GBert/EasyCAN/hardware/BOM.md

BOM
===

```
R1			4k7
R2,R7		330  (20mA LED)
R3			1k
R4			120
R5,R6		33
R8			1k	optional (MCP2551 bzw. 2561)

C1			100nF
C2,C3		22pF
C4-C7		100nF
C8,C9		100pF
C10			100nF	optional 

IC1			PIC18F25K80 or PIC18F26K80
Q1			16MHz

DC1			5V DCDC SIL4	optional
			NUP2105L        CAN protection optional 
```
