GBert/EasyCAN/(threads)

Thread 1 (2025-07-08):

Comparison operator wrong

WebDust21, 2025-07-08:
https://github.com/GBert/EasyCAN/blob/0a382b3a9a484f9f415d9f06ae92aa9af49ba99f/software/old/xc8_test/can/ecan.c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

This needs to be:

```
while (CANSTATbits.OPMODE != 0x00);
```

The only reason it doesn't lock up the processor indefinitely as written, is because the mode switch doesn't happen instantly.
