GBert/EasyCAN/hardware/GBox2-can_diy.pdf

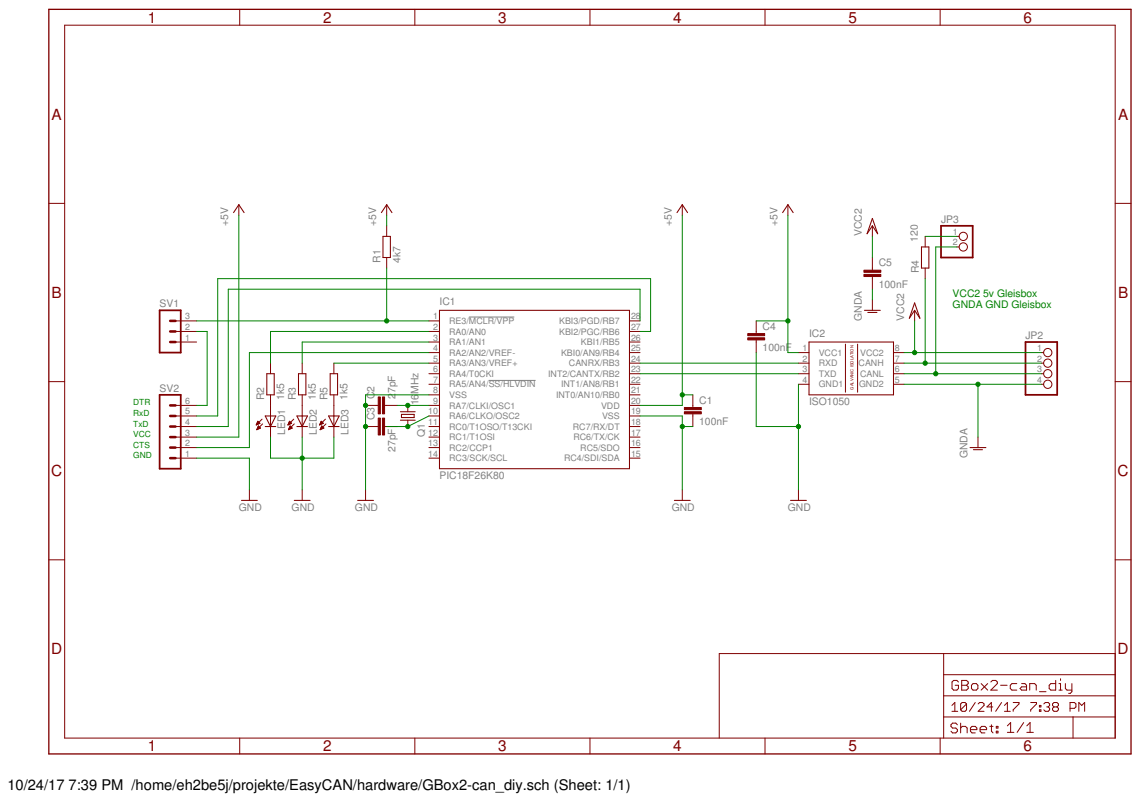
[picture p5: page 1]

VCC2 5v Gleisbox GNDA GND Gleisbox

10/24/17 7:39 PM /home/eh2be5j/projekte/EasyCAN/hardware/GBox2-can_diy.sch (Sheet: 1/1)
