GBert/EasyCAN/hardware/EasyCAN.pdf

# GND⁺⁵V

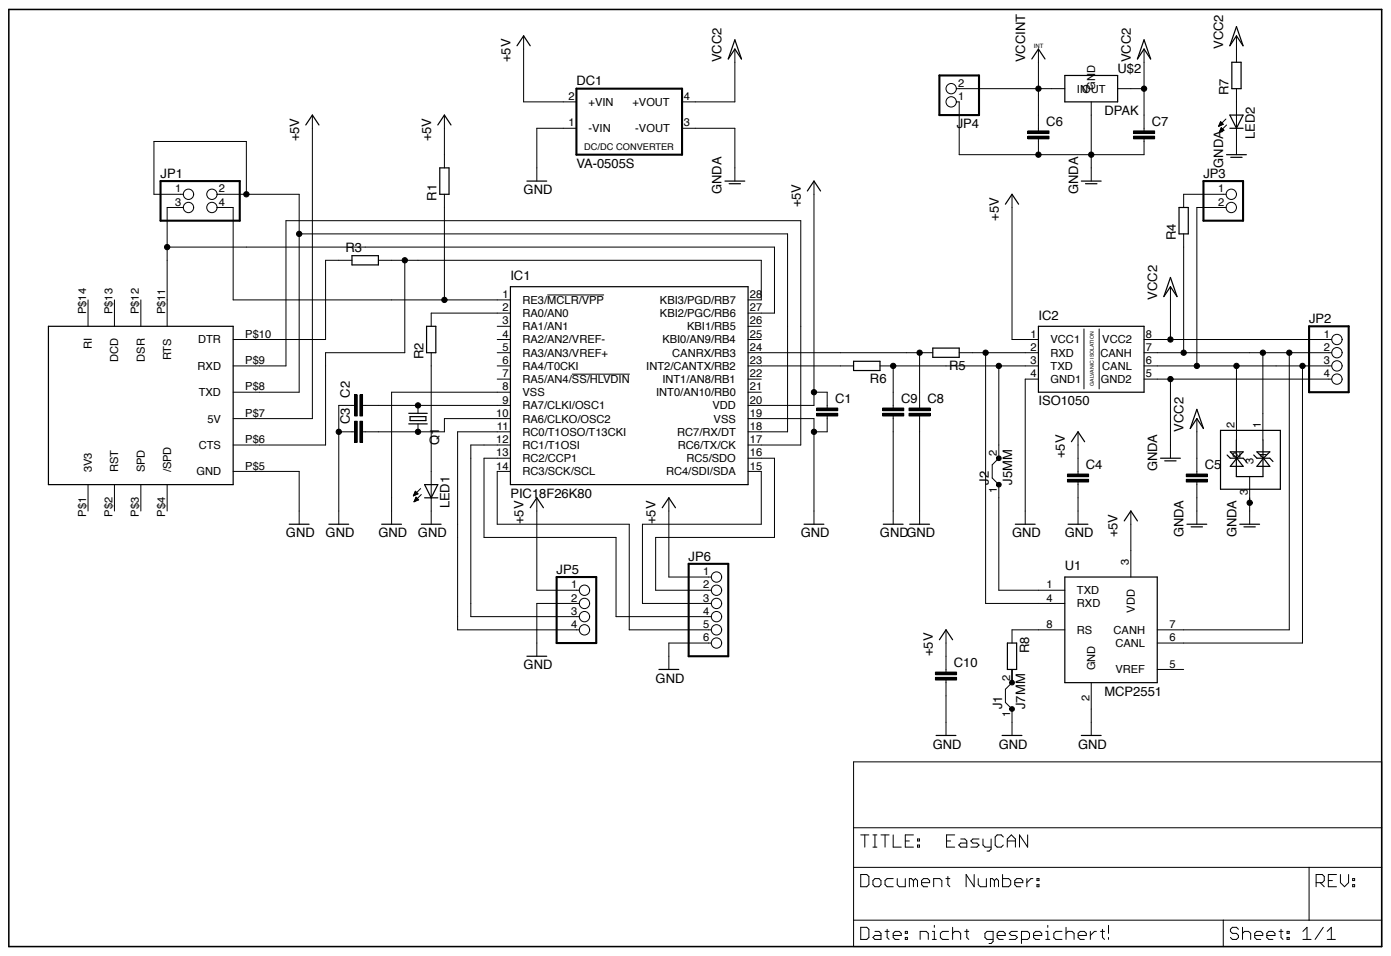
[picture p6: page 1]
