GBert/EasyCAN/hardware/EasyCAN_diy.pdf

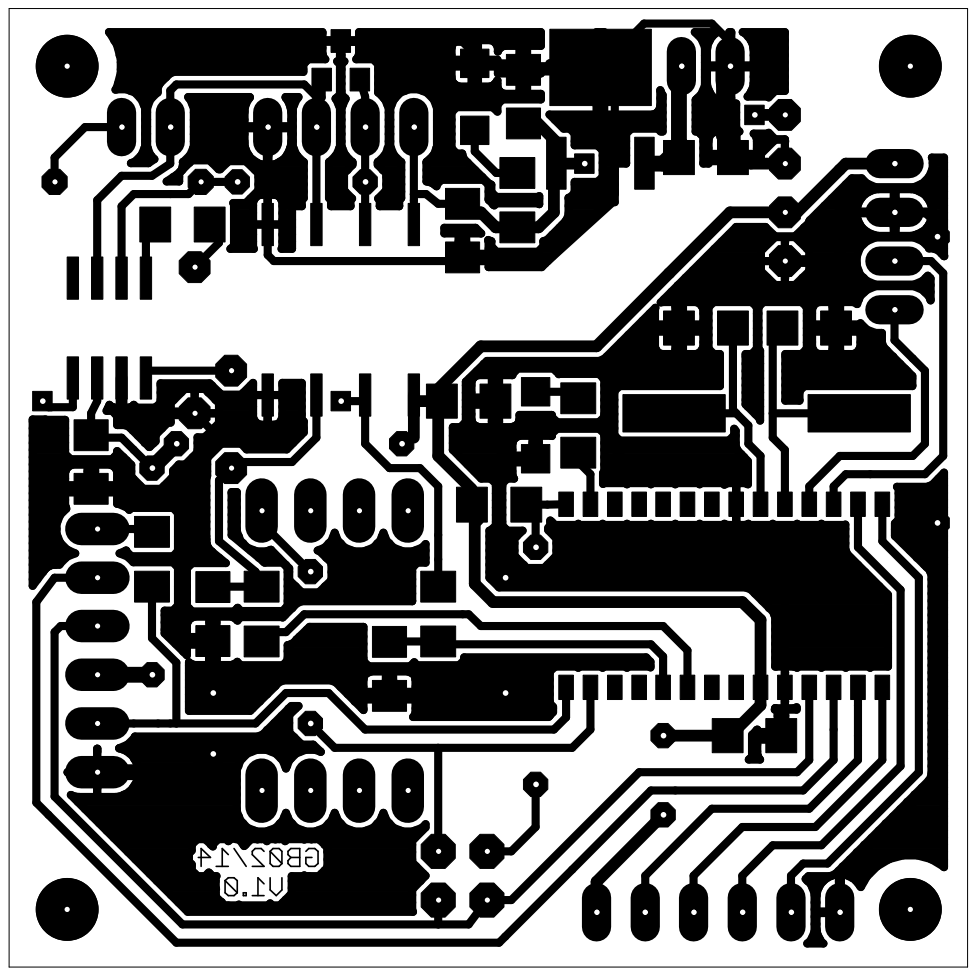
[picture p7: page 1]
