GBert/EasyCAN/hardware/EasyCAN_diy_multi.pdf

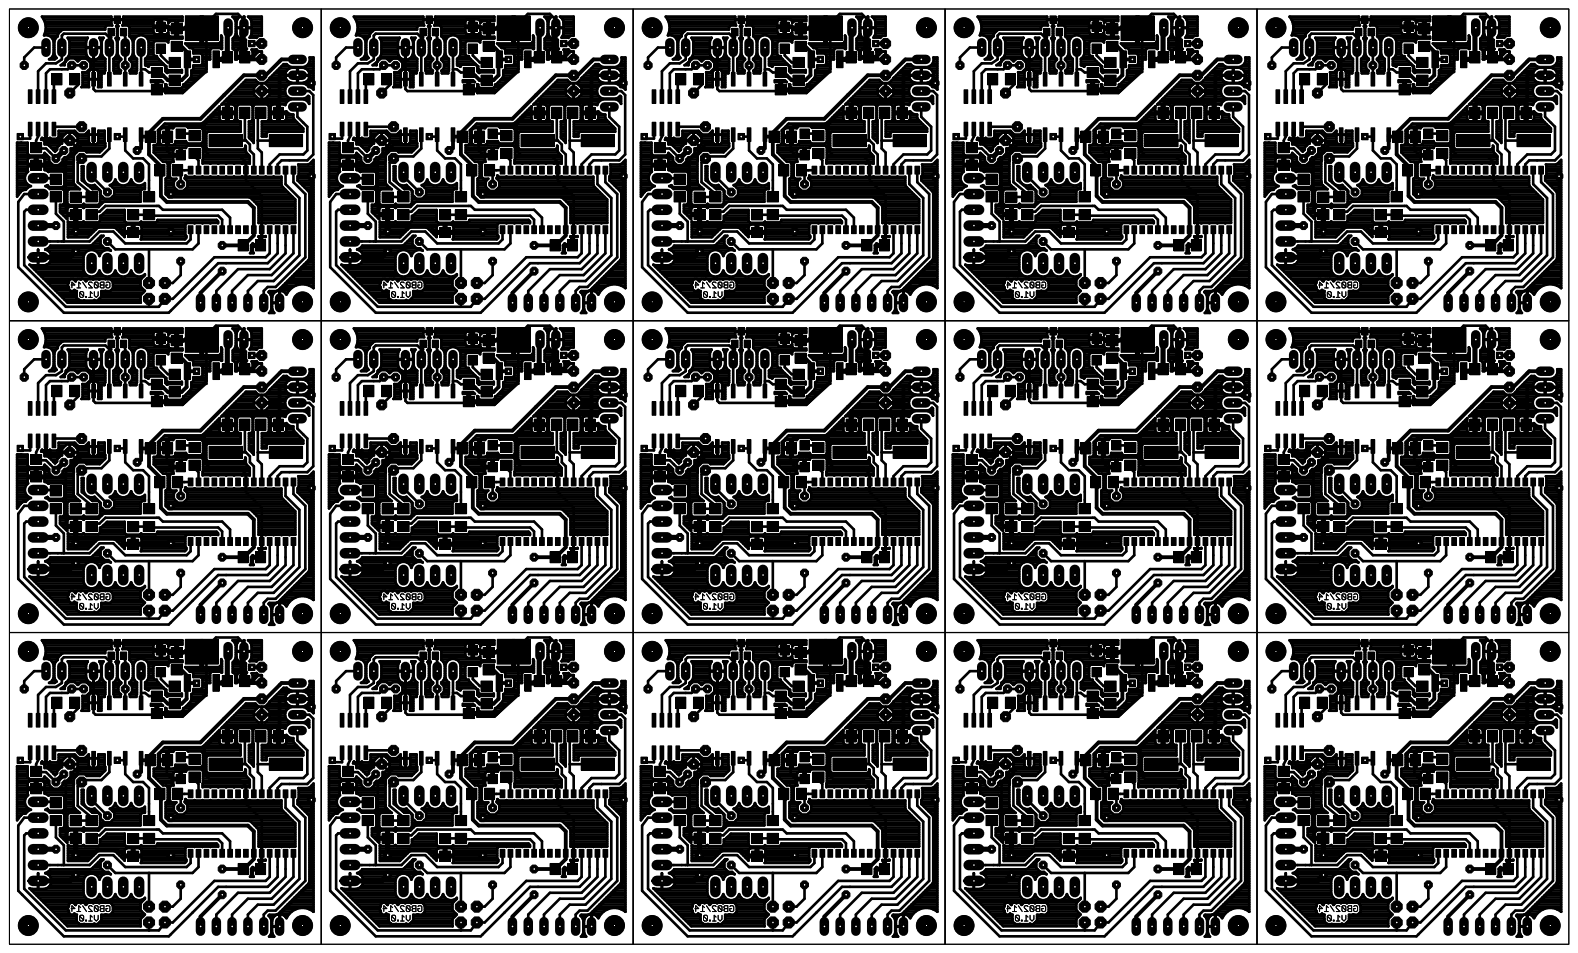
[picture p8: page 1]
