GBert/EasyCAN/hardware/wr841n/wr841n-pic.pdf

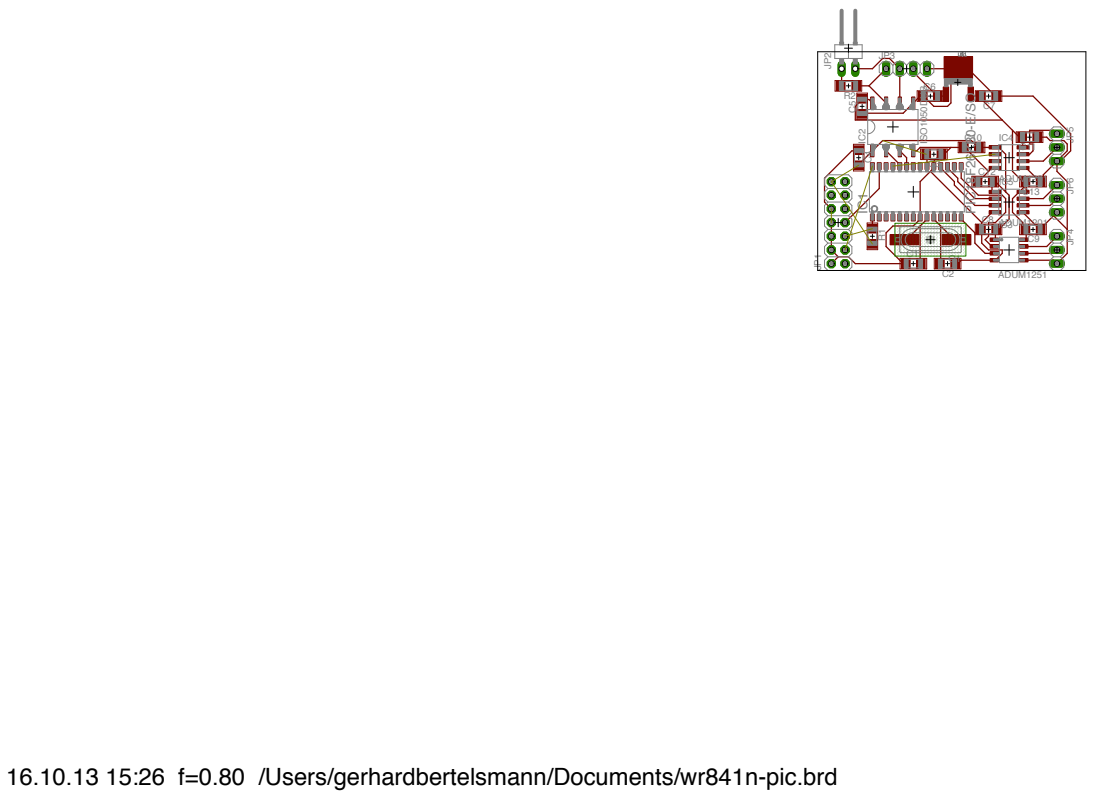
[picture p9: page 1]

16.10.13 15:26 f=0.80 /Users/gerhardbertelsmann/Documents/wr841n-pic.brd
