GBert/EasyCAN/hardware/wr841n/wr841n-pic.brd

## EAGLE design hardware/wr841n/wr841n-pic.brd (2014-12-09)

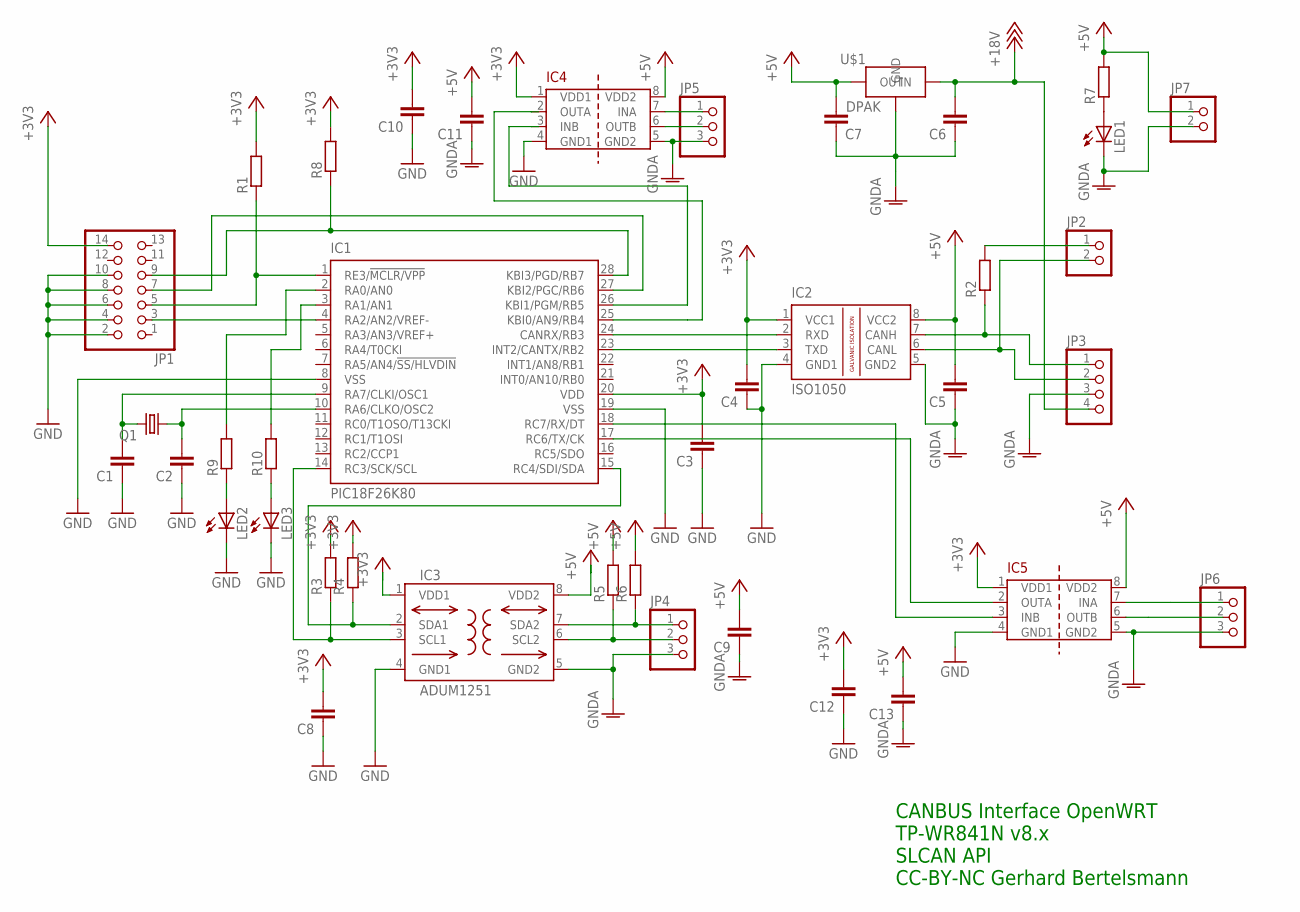
[picture p10: schematic wr841n-pic.sch]

Parts:
C1, C2, C3, C4, C5, C6, C7, C8, C9, C10, C11, C12, C13: C-EUC1206; C1206
IC1: PIC18F26K80; SO28W
IC2: ISO1050; DUB-R-PDSO-G8
IC3: ADUM1251; SO8-COOL
IC4, IC5: ADUM1201; SO8
JP1: PINHD-2X7; 2X07
JP2, JP7: PINHD-1X2; 1X02
JP3: PINHD-1X4; 1X04
JP4, JP5, JP6: PINHD-1X3; 1X03
LED1, LED2, LED3: LEDCHIPLED_1206; CHIPLED_1206
Q1: CRYSTALHC49UP; HC49UP
R1, R2, R3, R4, R5, R6, R7, R8, R9, R10: R-EU_R1206; R1206
U$1: 7805-DPAK

Connections:
+3V3: C3.2, C4.2, C8.2, C10.2, C12.2, IC1.20 (VDD), IC2.1 (VCC1), IC3.1 (VDD1), IC4.1 (VDD1), IC5.1 (VDD1), JP1.14, R1.2, R3.2, R4.2, R8.2
+5V: C5.2, C7.2, C9.2, C11.2, C13.2, IC2.8 (VCC2), IC3.8 (VDD2), IC4.8 (VDD2), IC5.8 (VDD2), JP7.1, R5.2, R6.2, R7.2, U$1.OUT; also elsewhere on the board
+18V: C6.2, JP3.4, U$1.IN; also elsewhere on the board
GND: C1.1, C2.1, C3.1, C4.1, C8.1, C10.1, C12.1, IC1.8 (VSS), IC1.19 (VSS), IC2.4 (GND1), IC3.4 (GND1), IC4.4 (GND1), IC5.4 (GND1), JP1.2, JP1.4, JP1.6, JP1.8, JP1.10, LED2.C, LED3.C
GNDA: C5.1, C6.1, C7.1, C9.1, C11.1, C13.1, IC2.5 (GND2), IC3.5 (GND2), IC4.5 (GND2), IC5.5 (GND2), JP3.3, JP4.3, JP5.3, JP6.3, JP7.2, LED1.C, U$1.GND; also elsewhere on the board
unnamed: C1.2, IC1.9 (RA7/CLKI/OSC1), Q1.2
unnamed: C2.2, IC1.10 (RA6/CLKO/OSC2), Q1.1
unnamed: IC1.1 (RE3/!MCLR/VPP), JP1.5, R1.1
unnamed: IC1.28 (KBI3/PGD/RB7), JP1.9, R8.1
unnamed: IC1.27 (KBI2/PGC/RB6), JP1.7
unnamed: IC1.24 (CANRX/RB3), IC2.2 (RXD)
unnamed: IC1.23 (INT2/CANTX/RB2), IC2.3 (TXD)
unnamed: IC2.7 (CANH), JP3.1, R2.1
unnamed: JP2.1, R2.2
unnamed: IC2.6 (CANL), JP2.2, JP3.2
unnamed: IC3.7 (SDA2), JP4.1, R6.1
unnamed: IC3.6 (SCL2), JP4.2, R5.1
unnamed: IC1.14 (RC3/SCK/SCL), IC3.3 (SCL1), R3.1
unnamed: IC1.15 (RC4/SDI/SDA), IC3.2 (SDA1), R4.1
unnamed: LED1.A, R7.1
unnamed: IC1.3 (RA1/AN1), R10.2
unnamed: IC4.7 (INA), JP5.1
unnamed: IC4.6 (OUTB), JP5.2
unnamed: IC1.17 (RC6/TX/CK), IC5.2 (OUTA)
unnamed: IC5.7 (INA), JP6.1
unnamed: IC5.6 (OUTB), JP6.2
unnamed: IC1.18 (RC7/RX/DT), IC5.3 (INB)
unnamed: IC1.4 (RA2/AN2/VREF-), JP1.3
unnamed: IC1.26 (KBI1/PGM/RB5), IC4.3 (INB)
unnamed: IC1.25 (KBI0/AN9/RB4), IC4.2 (OUTA)
unnamed: IC1.2 (RA0/AN0), R9.2
unnamed: LED2.A, R9.1
unnamed: LED3.A, R10.1

Notes on the sheet:
CANBUS Interface OpenWRT TP-WR841N v8.x SLCAN API CC-BY-NC Gerhard Bertelsmann

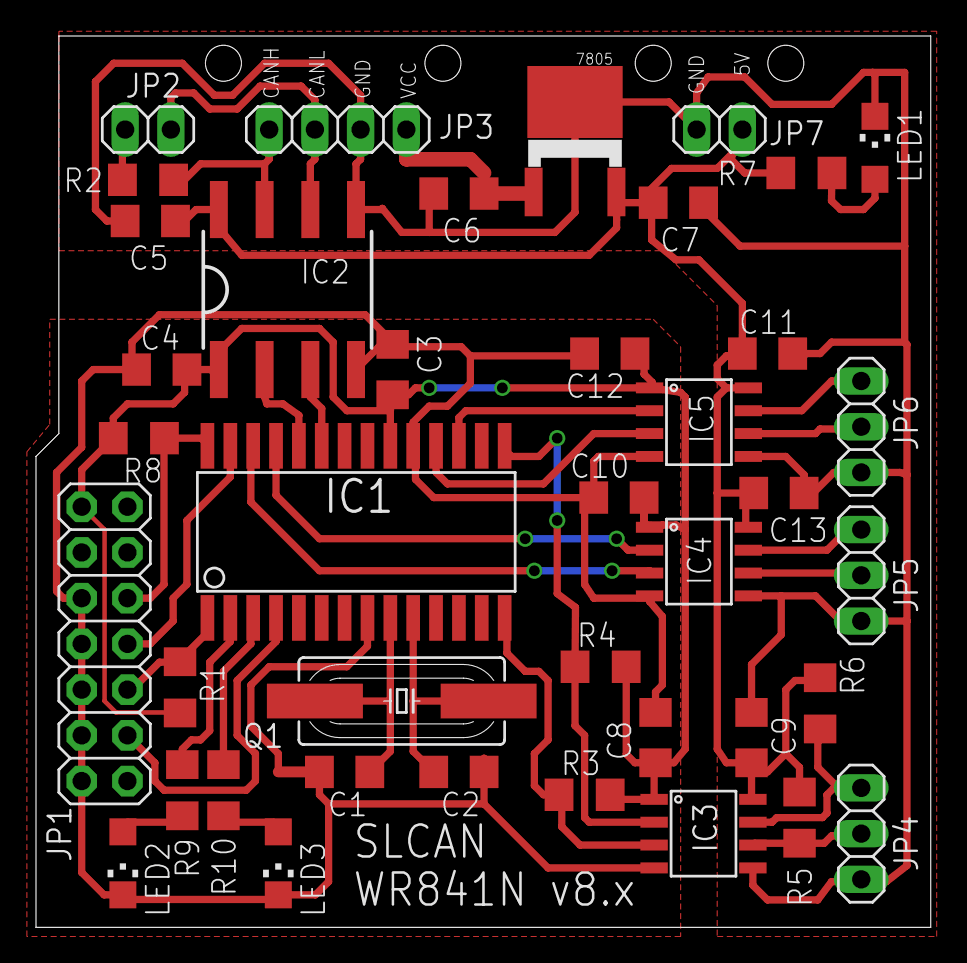
[picture p11: board wr841n-pic.brd from above]

Board: 2 copper layers, 49.7 x 49.5 mm, 40 parts (0 on the bottom side), 33 nets.

Other parts of the board:
7805: 7805-DPAK

Their connections:
+5V: 7805.OUT; also elsewhere on the board
+18V: 7805.IN; also elsewhere on the board
GNDA: 7805.GND; also elsewhere on the board
