GBert/EasyCAN/hardware/EasyCAN_diy.brd

## EAGLE design hardware/EasyCAN_diy.brd (2014-02-10)

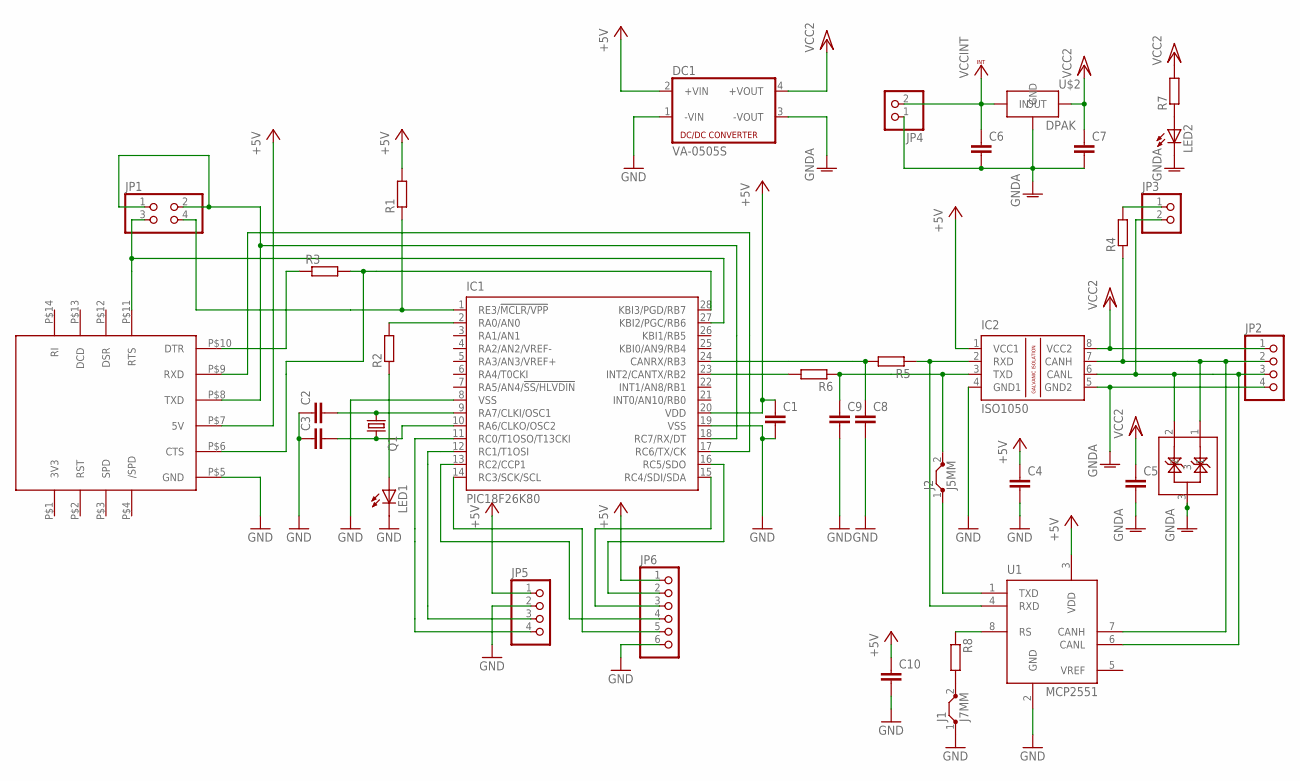
[picture p12: schematic EasyCAN_diy.sch]

Parts:
C1, C2, C3, C4, C5, C6, C7, C8, C9, C10: C-EUC1206; C1206
D1: NUP2105L; TO236
DC1: VA-0505S; 4SIL
IC1: PIC18F26K80; SO28W
IC2: ISO1050; DUB-R-PDSO-G8
J1: J7MM; 07
J2: J5MM; 05
JP1: PINHD-2X2; 2X02
JP2, JP5: PINHD-1X4; 1X04
JP3, JP4: PINHD-1X2; 1X02
JP6: PINHD-1X6; 1X06
LED1, LED2: LEDSML1206; SML1206
Q1: CRYSTALHC49UP; HC49UP
R1, R2, R3, R5, R6, R7, R8: R-EU_R1206; R1206
R4: R-EU_0204/7; 0204/7
U1: MCP2551; SO-08
U$1: BTE13-007
U$2: 7805-DPAK

Connections:
3V3: U$1.P$1 (3V3)
+5V: C1.1, C4.1, C10.1, DC1.2 (+VIN), IC1.20 (VDD), IC2.1 (VCC1), JP5.1, JP6.1, R1.2, U1.3 (VDD), U$1.P$7 (5V)
GND: C1.2, C2.1, C3.1, C4.2, C8.2, C9.2, C10.2, DC1.1 (-VIN), IC1.8 (VSS), IC1.19 (VSS), IC2.4 (GND1), J1.1, JP5.2, JP6.6, LED1.C, U1.2 (GND), U$1.P$5 (GND)
GNDA: C5.2, C6.2, C7.2, D1.3, DC1.3 (-VOUT), IC2.5 (GND2), JP2.4, JP4.1, LED2.C, U$2.GND
unnamed: IC1.18 (RC7/RX/DT), JP1.1, JP1.2, U$1.P$8 (TXD)
unnamed: IC1.17 (RC6/TX/CK), U$1.P$9 (RXD)
unnamed: C2.2, IC1.9 (RA7/CLKI/OSC1), Q1.2
unnamed: C3.2, IC1.10 (RA6/CLKO/OSC2), Q1.1
unnamed: IC1.2 (RA0/AN0), R2.2
unnamed: IC1.1 (RE3/!MCLR/VPP), JP1.4, R1.1
unnamed: IC1.27 (KBI2/PGC/RB6), JP1.3, U$1.P$11 (RTS)
unnamed: IC2.2 (RXD), R5.1, U1.4 (RXD)
unnamed: IC1.28 (KBI3/PGD/RB7), R3.2, U$1.P$6 (CTS)
unnamed: R3.1, U$1.P$10 (DTR)
unnamed: C8.1, IC1.24 (CANRX/RB3), R5.2
unnamed: J1.2, R8.2
unnamed: LED2.A, R7.1
unnamed: R8.1, U1.8 (RS)
unnamed: C9.1, IC2.3 (TXD), J2.2, R6.1
unnamed: JP3.1, R4.2
unnamed: LED1.A, R2.1
unnamed: IC1.11 (RC0/T1OSO/T13CKI), JP5.4
unnamed: IC1.12 (RC1/T1OSI), JP5.3
unnamed: IC1.13 (RC2/CCP1), JP6.4
unnamed: IC1.14 (RC3/SCK/SCL), JP6.5
unnamed: IC1.15 (RC4/SDI/SDA), JP6.3
unnamed: IC1.16 (RC5/SDO), JP6.2
unnamed: D1.2, IC2.6 (CANL), JP2.3, JP3.2, U1.6 (CANL)
unnamed: D1.1, IC2.7 (CANH), JP2.2, R4.1, U1.7 (CANH)
unnamed: IC1.23 (INT2/CANTX/RB2), R6.2
unnamed: J2.1, U1.1 (TXD)
VCC/2: C5.1, C7.1, DC1.4 (+VOUT), IC2.8 (VCC2), JP2.1, R7.2, U$2.OUT
VCCINT: C6.1, JP4.2, U$2.IN

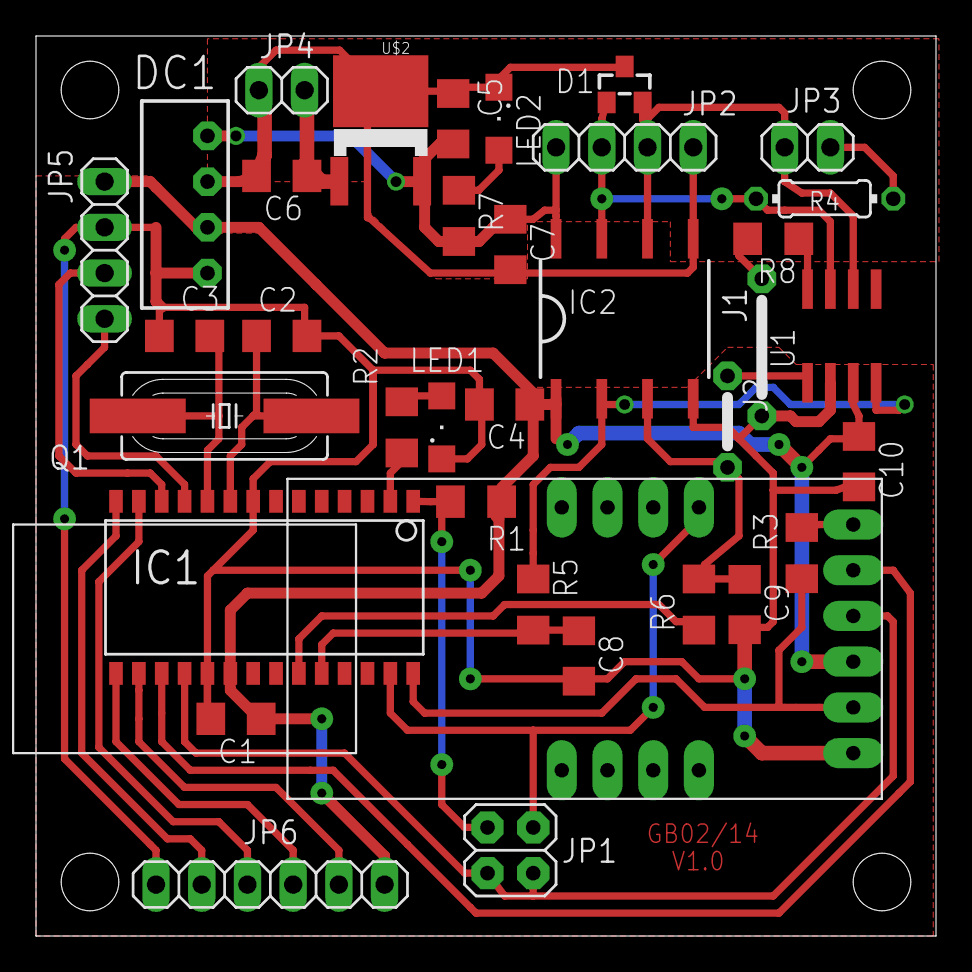
[picture p13: board EasyCAN_diy.brd from above]

Board: 2 copper layers, 50.0 x 50.0 mm, 36 parts (0 on the bottom side), 32 nets.
