GBert/EasyCAN/software/firmware/fw/easycan.asm

;------------------------------------------------------------------------------
;
; Can-Can Device
;
; Copyright (c) 2014 Darron M Broad
;
;------------------------------------------------------------------------------
;
; This file is part of the Can-Can CAN bus interface project.
;
; Can-Can is licensed under the CC BY-NC-SA 4.0.
;
; See file /LICENSE for details.
; 
;------------------------------------------------------------------------------

                RADIX   DEC

;------------------------------------------------------------------------------
; Device
;------------------------------------------------------------------------------

                PROCESSOR   18f26k80

;------------------------------------------------------------------------------
; Device constants
;------------------------------------------------------------------------------

                ERRORLEVEL  -302
                LIST        P=PIC18F26K80
#INCLUDE        "p18f26k80.inc"
                LIST

;------------------------------------------------------------------------------
; Device settings
;------------------------------------------------------------------------------

; Clock Rate
#DEFINE         CLOCK       64000000

; UART Baud Rate
#DEFINE         BAUDRATE    921600

; UART1 or UART2
#DEFINE         UART1

; CAN Bus Rate
#DEFINE         CANRATE     500

; Advanced LED Diags.
#DEFINE         LLED        LATA
#DEFINE         LTRIS       TRISA

;------------------------------------------------------------------------------
; Device firmware
;------------------------------------------------------------------------------

#INCLUDE        "can-can.inc"

;------------------------------------------------------------------------------
                END
;------------------------------------------------------------------------------
;
; vim: shiftwidth=4 tabstop=4 softtabstop=4 expandtab
;
