GBert/EasyCAN/software/sdcc_test/uart_blinky/main.c

/* ----------------------------------------------------------------------------
 * "THE BEER-WARE LICENSE" (Revision 42):
 * <info@gerhard-bertelsmann.de> wrote this file. As long as you retain this
 * notice you can do whatever you want with this stuff. If we meet some day,
 * and you think this stuff is worth it, you can buy me a beer in return
 * Gerhard Bertelsmann
 * ----------------------------------------------------------------------------
 */

#include "main.h"
#include "usart.h"
#include "prototypes.h"

#pragma config XINST=OFF

const char s1[] = "circular buffer is working!\r\n";
const char s2[] = "USART is working!\r\n";

volatile unsigned char timer_ticks=0;
struct serial_buffer tx_fifo, rx_fifo;

void init_port(void) {
    ADCON1 = 0x0F;		// Default all pins to digital
    LED_TRIS = 0;
}

void init_timer(void) {
    // time period = 1/16MHz = 0.0625 us
    // prescaler period = .0625us * 256 = 16us
    // overflow period  = 16us * 256 = 4.096ms
    T0CONbits.T0PS0=1;    //Prescaler is divide by 256
    T0CONbits.T0PS1=1;
    T0CONbits.T0PS2=1;

    T0CONbits.PSA=0;      //Timer Clock Source is from Prescaler
    T0CONbits.T0CS=0;     //Prescaler gets clock from FCPU (16MHz)

    T0CONbits.T08BIT=1;   //8 BIT MODE

    INTCONbits.TMR0IE=1;   //Enable TIMER0 Interrupt
    INTCONbits.PEIE=1;     //Enable Peripheral Interrupt
    INTCONbits.GIE=1;      //Enable INTs globally

    T0CONbits.TMR0ON=1;   //Now start the timer!
}

void main(void) {
    unsigned char do_print=0;
    unsigned char ret=0;
    unsigned char TaskB='A';
    char c;

    init_port();
    init_timer();
    init_usart();

    /* empty circular buffers */
    tx_fifo.head=0;
    tx_fifo.tail=0;
    rx_fifo.head=0;
    rx_fifo.tail=0;
    
    //infinite loop
    while(1) {
	if ((do_print == 0) && (timer_ticks == 10)) {
	    do_print = 1;
	}
	if ((do_print == 1) && (timer_ticks == 100)) {
	    do_print = 0;
	    puts_rom(s2);
	    ret=puts_rom_fifo(s1,&tx_fifo);
	}
	ret=fifo_putchar(&tx_fifo);
        if (c=fifo_getchar(&rx_fifo)) {
	    if (c==0x0d) {
	        copy_char_fifo(&rx_fifo,&tx_fifo);
		putchar_fifo(0x0a,&tx_fifo);
	    }
	}
    }
}

void isr() __interrupt 1 {
    if (INTCONbits.TMR0IE && INTCONbits.TMR0IF) {
        // overflow every 4.096ms
        timer_ticks++;
        if (timer_ticks==20) {  // 80 ms
            LED = 0;		// LED OFF
        }
        if (timer_ticks==40) {  // 80 ms
            LED = 1;		// LED ON
        }
        if (timer_ticks==60) {  // 80 ms
            LED = 0;		// LED OFF
        }
        if (timer_ticks==250) { // 720 ms
            LED = 1;		// LED OFF
            timer_ticks=0;
        }
        INTCONbits.TMR0IF = 0;
    }
}
