GBert/EasyCAN/(commit log)

2014-02-10 add Eagle files for DIY
    [EasyCAN_diy.brd, EasyCAN_diy.sch]
2014-02-11 try to fix uart init
2014-02-17 cli: add some pic ids and fix debug print
    [main.c]
2014-02-17 fix RTS handling - part I
    [main.c]
2014-02-17 fix RTS handling - part II
    [main.c]
2014-02-20 stretch RTS / PIC reset
    [main.c]
2014-03-05 xc8 testing
    [l.obj]
2014-03-05 add files from bt-relay
2014-03-05 uart test
2014-03-05 uart test - wip part XIV
2014-03-06 fix termios settings (why ? i don't know)
    [main.c]
2014-06-25 writing data works. but GOTO bootloader is missing - still dirty hack
    [pirate-loader.c]
2014-06-25 switch back to word size - try to fix 'fix jump'
    [pirate-loader.c]
2014-06-25 try to fix 'fix jump' wip
    [pirate-loader.c]
2014-06-25 wip - fix word handling
    [pirate-loader.c]
2014-06-25 fix PIC WORD SIZE
    [pirate-loader.c]
2014-06-26 fixed jumps - hopefully
    [pirate-loader.c]
2014-06-26 fix jumps - again
    [pirate-loader.c]
2014-06-26 fix jumps - again and again
    [pirate-loader.c]
2014-06-27 first working version - reduce some printfs
2014-06-28 add schematic pdf
2014-06-30 try timer0 interrupt
2014-07-01 start writing the ultimate code ...
    [easycan.obj, l.obj, startup.obj]
2014-07-02 add test for UART fifo
2014-07-02 fix circular buffer handling - change return values
    [usart.c]
2014-07-03 fifo print out of order - try a single char
2014-07-03 fixed sending char - yahooooo
    [main.c, usart.c]
2014-07-03 fix hex print
2014-07-06 famous blinky with sdcc - fails on ds30loader
    [main.c, main.h, usart.c, usart.h]
2014-07-07 add vV switch SLCAN
2014-07-09 after fixing dsloader (XINST and WDT off) try some code
    [main.c, main.h, usart.c]
2014-07-11 fix receiver fifo wrap around
    [usart.c]
2014-07-17 sfr print fun - wip
2014-07-24 change mask to accept all CAN frames and add some debugging
2014-07-27 first attemp to send CAN frame. Works, but BRGCONxs are still wrong ...
    [main.c, prototypes.h]
2014-07-28 try to find out why extended CAN frames are blocked
2014-07-28 fix extended CAN frame filter&mask
2014-07-28 decode RX CAN frame -> SLCAN - wip
2014-08-02 note that port.de is correct
2014-11-15 add trial Makefile switch for fast trial&error
2014-11-17 switch all ports to digital
2014-11-17 can-can still not working here ...
    [can-can.c]
2014-11-18 set XSTA to the first UART
2014-11-19 uart tweaking - now 250k TX CAN ready !
2014-11-19 tweak UART settings
2014-11-20 add some generic UART defines
2014-11-21 new stage
2014-11-26 use new version add fix CAN startup
    [can-can.c, pic18f26k80.asm]
2014-11-29 prepare fixing rx overload
    [pic18f26k80.asm, proton-mkII-4685.asm]
2014-11-29 fix CANRX overflow - simply drop it
    [pic18f26k80.asm]
2014-11-29 fix flow control
2014-11-30 LED modify
2014-12-05 add WR841 temporarily
    [wr841n-pic.brd, wr841n-pic.sch]
2014-12-07 CAN-CAN WR841N PCB wip
    [wr841n-pic.brd]
2014-12-08 finalize PCB -> manufactor
    [wr841n-pic.GBL, wr841n-pic.GBO, wr841n-pic.GBS, wr841n-pic.GTL, wr841n-pic.GTO, wr841n-pic.GTS]
2014-12-08 add license
    [wr841n-pic.sch]
2014-12-09 change IC1 outline
    [wr841n-pic.brd]
2014-12-09 reflect changes in Gerber files
    [wr841n-pic.GTO]
2015-09-07 add DIY Gleisbox CAN Interface
    [GBox2-can_diy.sch]
2016-07-05 add BOM
2016-07-05 fix BOM
2017-10-24 update schematic
    [GBox2-can_diy.sch]
