GBert/EasyCAN/(notices)

Notices in the files:
software/firmware/etc/slcand_rts.c:
This program is free software; you can redistribute it and/or modify
the Free Software Foundation; either version 2 of the License, or
(at your option) any later version.
